baku89/smartknob/(commit log)

2024-01-27 Organize the base PCB for group buy
    [view_base.kicad_pcb, view_base.kicad_sch]
2024-01-27 Use KiCad 7.0 for GitHub workflow
2024-01-27 Revert the silkscreen for PCB versioning
    [view_base.kicad_pcb]
2024-01-27 Upgrade Kikit to v1.4.0 to support KiCad 7.0
2024-01-27 Remove exclude edge layer option in pcb_util.py
2024-01-27 Configure export options for JLCPCB
    [view_base.kicad_pcb]
2024-01-28 Add torque multipliers for BLDC to limit current
2024-01-28 Set the torque weak
2024-01-28 Switch a meter based on state.config.meter_type
2024-01-28 Replace uint16 led_hue with uint32 base_color in SmartKnobConfig protobuf
2024-01-28 Rewrite led_hue field in configs with 24-bit hex color
2024-01-28 Tint the 8 LEDs based on config.base_color
2024-01-28 Refactor the code to draw the text for current position
2024-01-29 Add new field corresponding to meter_center to sample configs
2024-01-29 Switch presets on pressing the knob
